nityc-d-robo/solenoid_driver/sd_hardware/sd_hardware.kicad_pcb

## KiCad design sd_hardware/sd_hardware.kicad_pcb (2026-10-19)

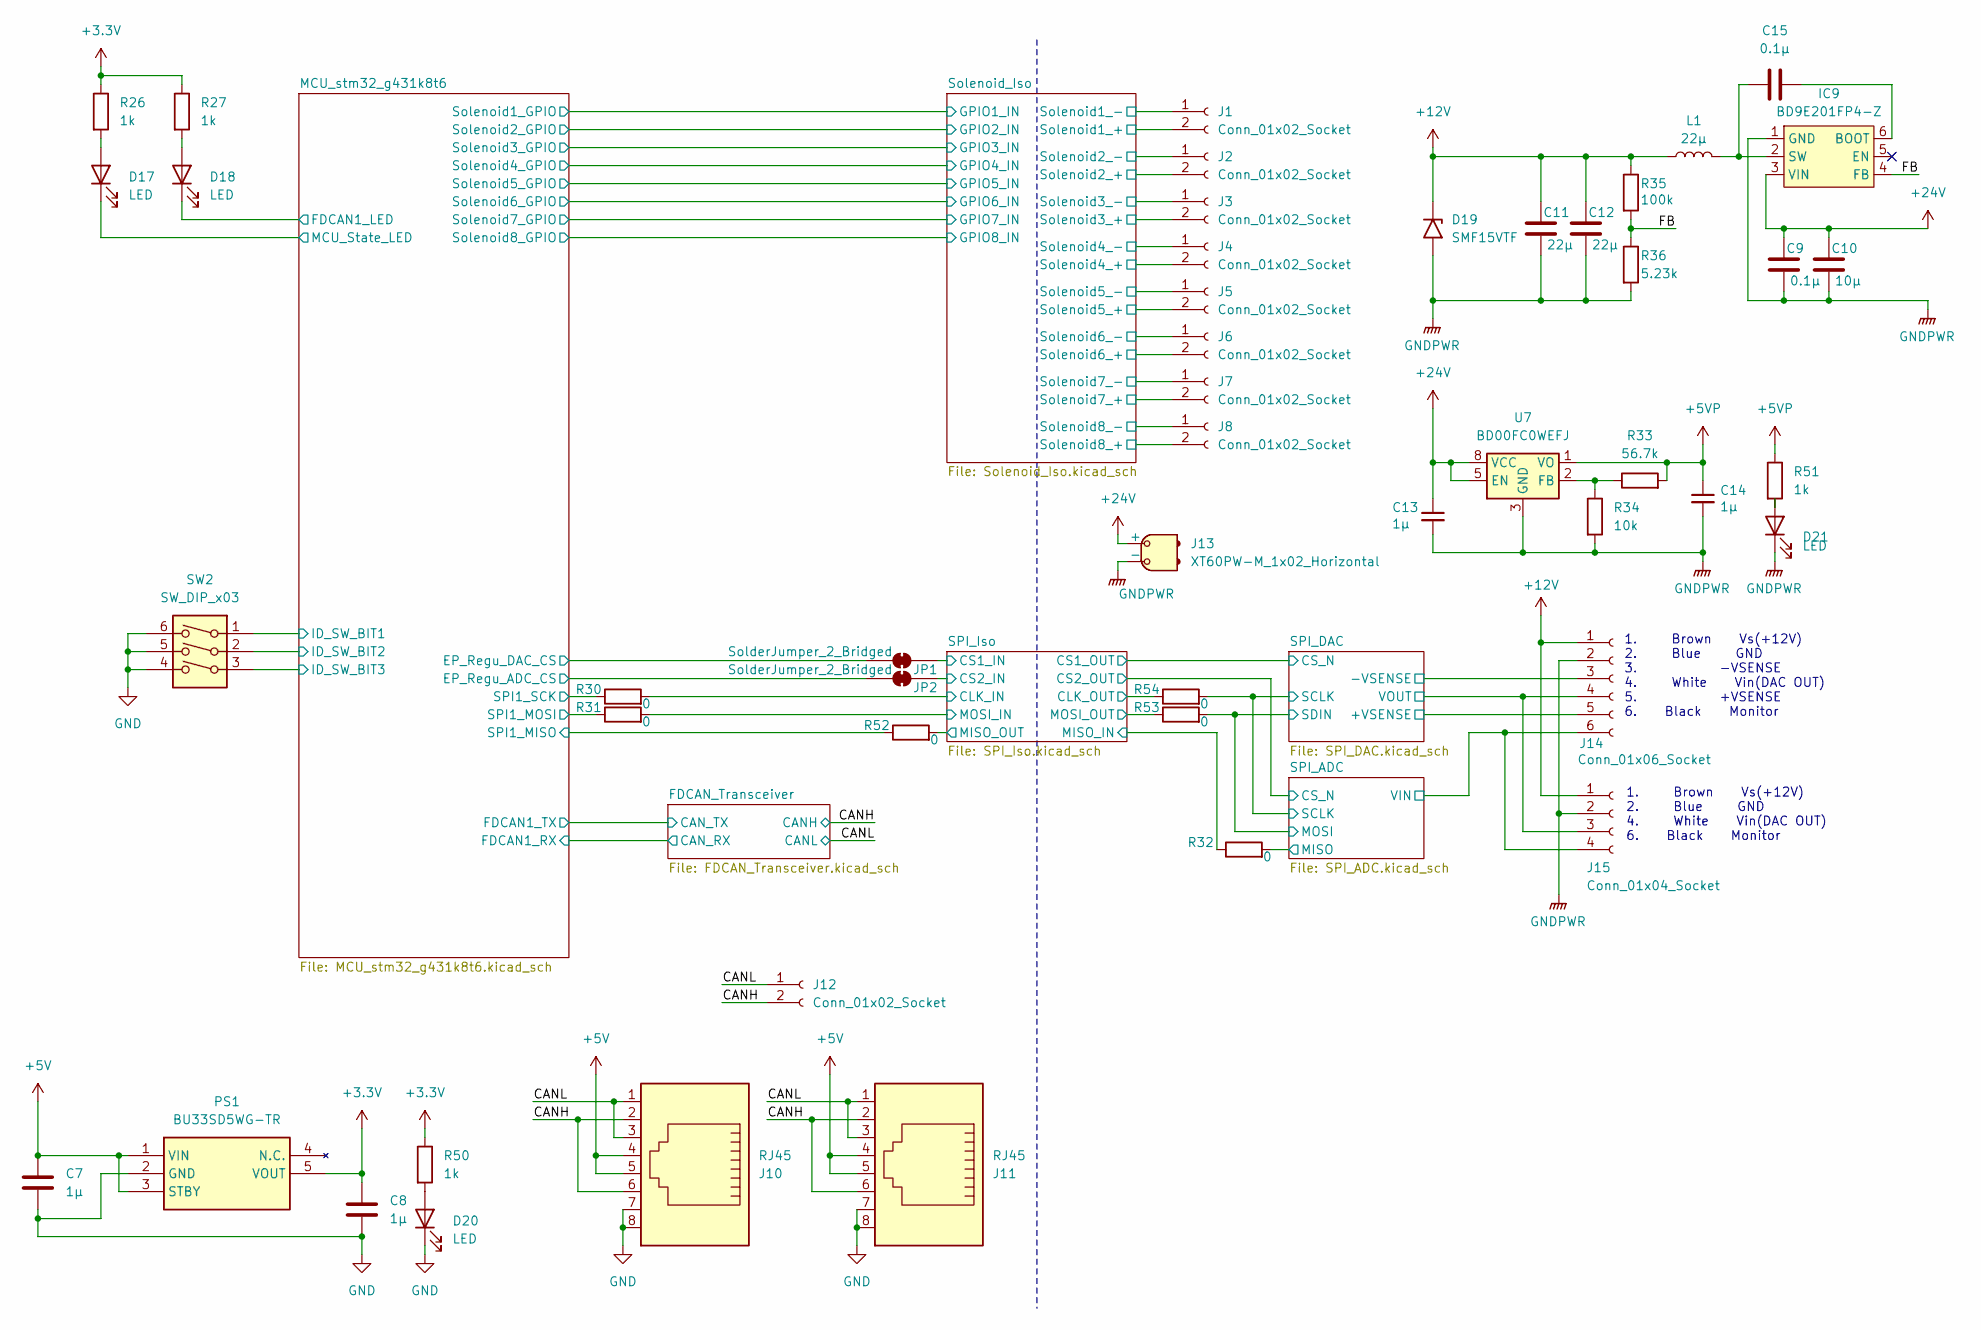
[picture p1: schematic sd_hardware.kicad_sch, Solenoid_Driver_3.1 - Yamana]

Parts:
C7, C8, C13, C14: 1μ; C_0603_1608Metric_Pad1.08x0.95mm_HandSolder
C9, C15: 0.1μ; C_0603_1608Metric_Pad1.08x0.95mm_HandSolder
C10: 10μ; C_0603_1608Metric_Pad1.08x0.95mm_HandSolder
C11, C12: 22μ; C_1210_3225Metric_Pad1.33x2.70mm_HandSolder
D17, D18, D20, D21: LED; LED_0603_1608Metric_Pad1.05x0.95mm_HandSolder
D19: SMF15VTF; D_SOD-123F
IC9: BD9E201FP4-Z; TSOT-23-6
J1, J2, J3, J4, J5, J6, J7, J8, J12: Conn_01x02_Socket; JST_XH_B2B-XH-A_1x02_P2.50mm_Vertical
J10, J11: RJ45; RJ45_Amphenol_54602-x08_Horizontal
J13: XT60PW-M_1x02_Horizontal; AMASS_XT60PW-M_1x02_P7.20mm_Horizontal
J14: Conn_01x06_Socket; JST_XH_B6B-XH-A_1x06_P2.50mm_Vertical
J15: Conn_01x04_Socket; JST_XH_B4B-XH-A_1x04_P2.50mm_Vertical
JP1, JP2: SolderJumper_2_Bridged; SolderJumper-2_P1.3mm_Bridged2Bar_RoundedPad1.0x1.5mm
L1: 22μ; RP1315BNP-220M
PS1: BU33SD5WG-TR; SOT95P280X125-5N; Mouser Part Number 755-BU33SD5WG-TR
R26, R27, R50, R51: 1k; R_0603_1608Metric_Pad0.98x0.95mm_HandSolder
R30, R31, R32, R52, R53, R54: 0; R_0603_1608Metric_Pad0.98x0.95mm_HandSolder
R33: 56.7k; R_0603_1608Metric_Pad0.98x0.95mm_HandSolder
R34: 10k; R_0603_1608Metric_Pad0.98x0.95mm_HandSolder
R35: 100k; R_0603_1608Metric_Pad0.98x0.95mm_HandSolder
R36: 5.23k; R_0603_1608Metric_Pad0.98x0.95mm_HandSolder
SW2: SW_DIP_x03; DS04-254-2-03BK-SMT
U7: BD00FC0WEFJ; HTSOP-8-1EP_3.9x4.9mm_P1.27mm_EP2.4x3.2mm

Connections:
+3.3V: C8.1, PS1.5 (VOUT), R26.1, R27.1, R50.1; also elsewhere on the board
+5V: C7.1, J10.4, J10.5, J11.4, J11.5, PS1.1 (VIN), PS1.3 (STBY); also elsewhere on the board
+5VP: C14.1, R33.2, R51.1, U7.1 (VO); also elsewhere on the board
+12V: C11.1, C12.1, D19.1 (A1), J1.2, J2.2, J3.2, J4.2, J5.2, J6.2, J7.2, J8.2, J14.1, J15.1, L1.1, R35.1; also elsewhere on the board
+24V: C9.1, C10.1, C13.1, IC9.3 (VIN), J13.2 (+), U7.5 (EN), U7.8 (VCC)
/CANH: J10.2, J10.6, J11.2, J11.6, J12.2; also elsewhere on the board
/CANL: J10.1, J10.3, J11.1, J11.3, J12.1; also elsewhere on the board
/FB: IC9.4 (FB), R35.2, R36.1
/MCU_stm32_g431k8t6/EP_Regu_ADC_CS: JP2.1 (A); also elsewhere on the board
/MCU_stm32_g431k8t6/EP_Regu_DAC_CS: JP1.1 (A); also elsewhere on the board
/MCU_stm32_g431k8t6/FDCAN1_LED: D18.1 (K); also elsewhere on the board
/MCU_stm32_g431k8t6/ID_SW_BIT1: SW2.1; also elsewhere on the board
/MCU_stm32_g431k8t6/ID_SW_BIT2: SW2.2; also elsewhere on the board
/MCU_stm32_g431k8t6/ID_SW_BIT3: SW2.3; also elsewhere on the board
/MCU_stm32_g431k8t6/MCU_State_LED: D17.1 (K); also elsewhere on the board
/MCU_stm32_g431k8t6/SPI1_MISO: R52.1; also elsewhere on the board
/MCU_stm32_g431k8t6/SPI1_MOSI: R31.1; also elsewhere on the board
/MCU_stm32_g431k8t6/SPI1_SCK: R30.1; also elsewhere on the board
/SPI_ADC/MISO: R32.2; also elsewhere on the board
/SPI_ADC/MOSI: R53.2; also elsewhere on the board
/SPI_ADC/SCLK: R54.2; also elsewhere on the board
/SPI_ADC/VIN: J14.6, J15.4; also elsewhere on the board
/SPI_DAC/+VSENSE: J14.5; also elsewhere on the board
/SPI_DAC/-VSENSE: J14.3; also elsewhere on the board
/SPI_DAC/VOUT: J14.4, J15.3; also elsewhere on the board
/SPI_Iso/CLK_IN: R30.2; also elsewhere on the board
/SPI_Iso/CLK_OUT: R54.1; also elsewhere on the board
/SPI_Iso/CS1_IN: JP1.2 (B); also elsewhere on the board
/SPI_Iso/CS2_IN: JP2.2 (B); also elsewhere on the board
/SPI_Iso/MISO_IN: R32.1; also elsewhere on the board
/SPI_Iso/MISO_OUT: R52.2; also elsewhere on the board
/SPI_Iso/MOSI_IN: R31.2; also elsewhere on the board
/SPI_Iso/MOSI_OUT: R53.1; also elsewhere on the board
/Solenoid_Iso/PhotoRelay1_Drain: J1.1; also elsewhere on the board
/Solenoid_Iso/PhotoRelay2_Drain: J2.1; also elsewhere on the board
/Solenoid_Iso/PhotoRelay3_Drain: J3.1; also elsewhere on the board
/Solenoid_Iso/PhotoRelay4_Drain: J4.1; also elsewhere on the board
/Solenoid_Iso/PhotoRelay5_Drain: J5.1; also elsewhere on the board
/Solenoid_Iso/PhotoRelay6_Drain: J6.1; also elsewhere on the board
/Solenoid_Iso/PhotoRelay7_Drain: J7.1; also elsewhere on the board
/Solenoid_Iso/PhotoRelay8_Drain: J8.1; also elsewhere on the board
GND: C7.2, C8.2, D20.1 (K), J10.7, J10.8, J11.7, J11.8, PS1.2 (GND), SW2.4, SW2.5, SW2.6; also elsewhere on the board
GNDPWR: C9.2, C10.2, C11.2, C12.2, C13.2, C14.2, D19.2 (A2), D21.1 (K), IC9.1 (GND), J13.1 (-), J14.2, J15.2, R34.2, R36.2, U7.3 (GND), U7.9 (GND); also elsewhere on the board
unnamed: D17.2 (A), R26.2
unnamed: D18.2 (A), R27.2
unnamed: D20.2 (A), R50.2
unnamed: D21.2 (A), R51.2
unnamed: C15.2, IC9.6 (BOOT)
unnamed: C15.1, IC9.2 (SW), L1.2
unnamed: R33.1, R34.1, U7.2 (FB)

Notes on the sheet:
1. Brown Vs(+12V) 2. Blue GND 3. -VSENSE 4. White Vin(DAC OUT) 5. +VSENSE 6. Black Monitor
1. Brown Vs(+12V) 2. Blue GND 4. White Vin(DAC OUT) 6. Black Monitor

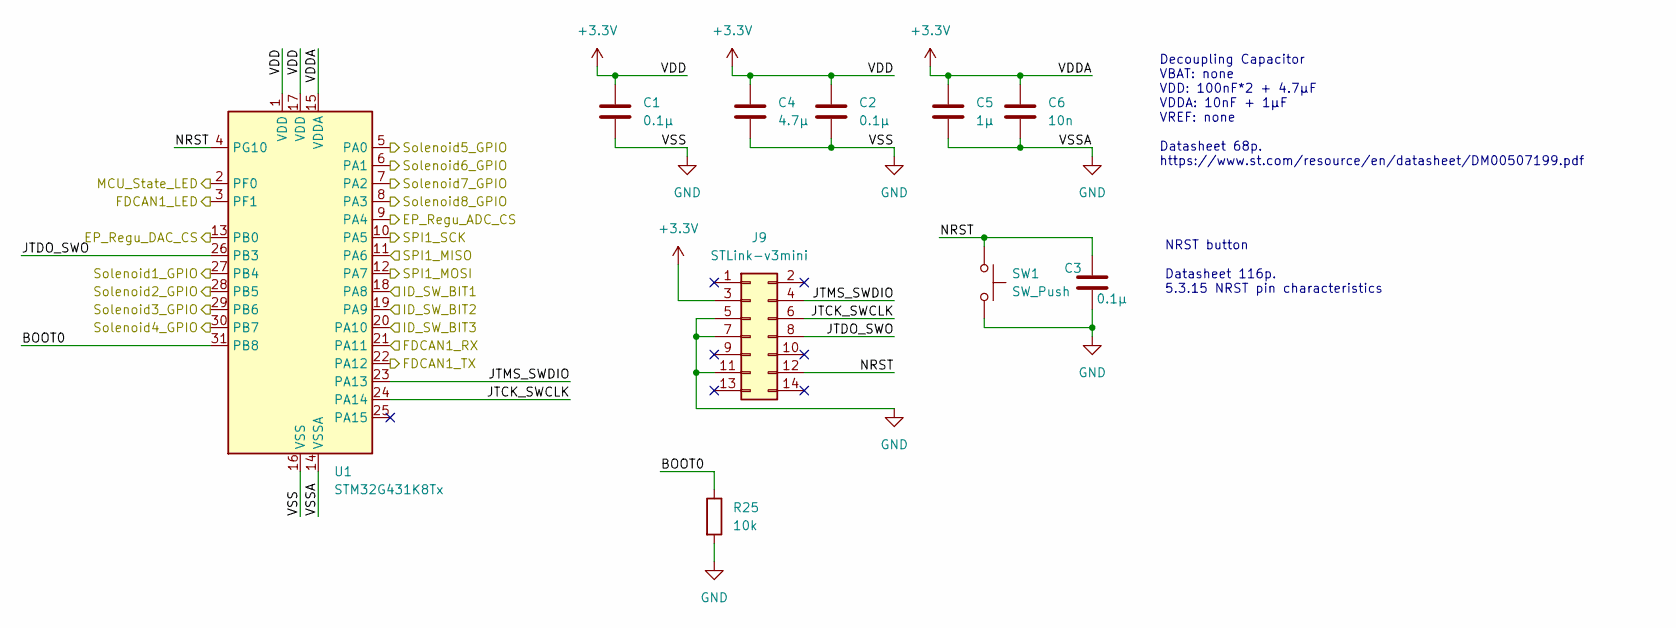
[picture p2: schematic MCU_stm32_g431k8t6.kicad_sch, Solenoid_Driver_3.1 - Yamana]

Parts:
C1, C2, C3: 0.1μ; C_0603_1608Metric_Pad1.08x0.95mm_HandSolder
C4: 4.7μ; C_0603_1608Metric_Pad1.08x0.95mm_HandSolder
C5: 1μ; C_0603_1608Metric_Pad1.08x0.95mm_HandSolder
C6: 10n; C_0603_1608Metric_Pad1.08x0.95mm_HandSolder
J9: STLink-v3mini; CONN14_3220-14_CNC
R25: 10k; R_0603_1608Metric_Pad0.98x0.95mm_HandSolder
SW1: SW_Push; TVAF06-A020B-R
U1: STM32G431K8Tx; LQFP-32_7x7mm_P0.8mm

Connections:
+3.3V: C1.1, C2.1, C4.1, C5.1, C6.1, J9.3, U1.1 (VDD), U1.15 (VDDA), U1.17 (VDD); also elsewhere on the board
/FDCAN_Transceiver/CAN_RX: U1.21 (PA11); also elsewhere on the board
/FDCAN_Transceiver/CAN_TX: U1.22 (PA12); also elsewhere on the board
/MCU_stm32_g431k8t6/BOOT0: R25.1, U1.31 (PB8)
/MCU_stm32_g431k8t6/EP_Regu_ADC_CS: U1.9 (PA4); also elsewhere on the board
/MCU_stm32_g431k8t6/EP_Regu_DAC_CS: U1.13 (PB0); also elsewhere on the board
/MCU_stm32_g431k8t6/FDCAN1_LED: U1.3 (PF1); also elsewhere on the board
/MCU_stm32_g431k8t6/ID_SW_BIT1: U1.18 (PA8); also elsewhere on the board
/MCU_stm32_g431k8t6/ID_SW_BIT2: U1.19 (PA9); also elsewhere on the board
/MCU_stm32_g431k8t6/ID_SW_BIT3: U1.20 (PA10); also elsewhere on the board
/MCU_stm32_g431k8t6/JTCK_SWCLK: J9.6, U1.24 (PA14)
/MCU_stm32_g431k8t6/JTDO_SWO: J9.8, U1.26 (PB3)
/MCU_stm32_g431k8t6/JTMS_SWDIO: J9.4, U1.23 (PA13)
/MCU_stm32_g431k8t6/MCU_State_LED: U1.2 (PF0); also elsewhere on the board
/MCU_stm32_g431k8t6/NRST: C3.1, J9.12, SW1.1, U1.4 (PG10)
/MCU_stm32_g431k8t6/SPI1_MISO: U1.11 (PA6); also elsewhere on the board
/MCU_stm32_g431k8t6/SPI1_MOSI: U1.12 (PA7); also elsewhere on the board
/MCU_stm32_g431k8t6/SPI1_SCK: U1.10 (PA5); also elsewhere on the board
/MCU_stm32_g431k8t6/Solenoid1_GPIO: U1.27 (PB4); also elsewhere on the board
/MCU_stm32_g431k8t6/Solenoid2_GPIO: U1.28 (PB5); also elsewhere on the board
/MCU_stm32_g431k8t6/Solenoid3_GPIO: U1.29 (PB6); also elsewhere on the board
/MCU_stm32_g431k8t6/Solenoid4_GPIO: U1.30 (PB7); also elsewhere on the board
/MCU_stm32_g431k8t6/Solenoid5_GPIO: U1.5 (PA0); also elsewhere on the board
/MCU_stm32_g431k8t6/Solenoid6_GPIO: U1.6 (PA1); also elsewhere on the board
/MCU_stm32_g431k8t6/Solenoid7_GPIO: U1.7 (PA2); also elsewhere on the board
/MCU_stm32_g431k8t6/Solenoid8_GPIO: U1.8 (PA3); also elsewhere on the board
GND: C1.2, C2.2, C3.2, C4.2, C5.2, C6.2, J9.5, J9.7, J9.11, R25.2, SW1.2, U1.14 (VSSA), U1.16 (VSS), U1.32 (VSS); also elsewhere on the board

Notes on the sheet:
Decoupling Capacitor VBAT: none VDD: 100nF*2 + 4.7μF VDDA: 10nF + 1μF VREF: none Datasheet 68p. https://www.st.com/resource/en/datasheet/DM00507199.pdf
NRST button Datasheet 116p. 5.3.15 NRST pin characteristics

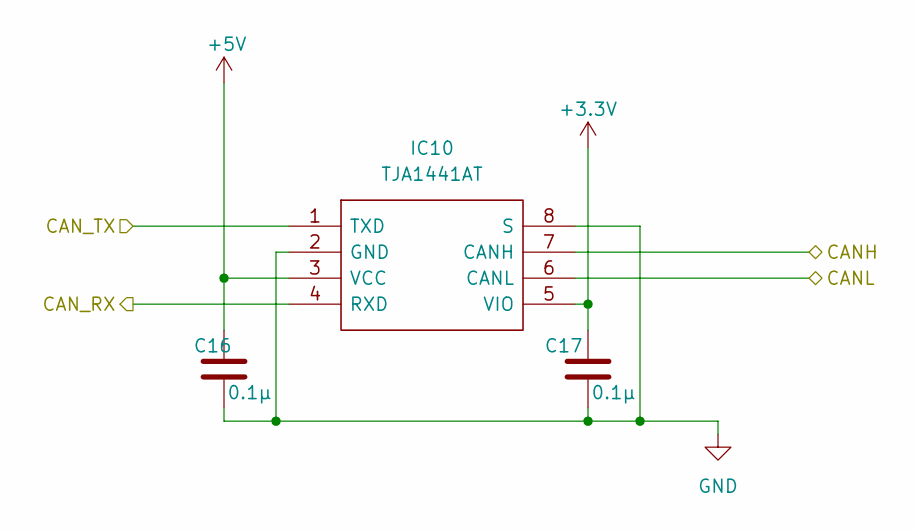
[picture p3: schematic FDCAN_Transceiver.kicad_sch, Solenoid_Driver_3.1 - Yamana]

Parts:
C16, C17: 0.1μ; C_0603_1608Metric_Pad1.08x0.95mm_HandSolder
IC10: TJA1441AT; SOIC127P600X175-8N; Manufacturer_Part_Number TJA1441AT

Connections:
+3.3V: C17.1, IC10.5 (VIO); also elsewhere on the board
+5V: C16.1, IC10.3 (VCC); also elsewhere on the board
/CANH: IC10.7 (CANH); also elsewhere on the board
/CANL: IC10.6 (CANL); also elsewhere on the board
/FDCAN_Transceiver/CAN_RX: IC10.4 (RXD); also elsewhere on the board
/FDCAN_Transceiver/CAN_TX: IC10.1 (TXD); also elsewhere on the board
GND: C16.2, C17.2, IC10.2 (GND), IC10.8 (S); also elsewhere on the board

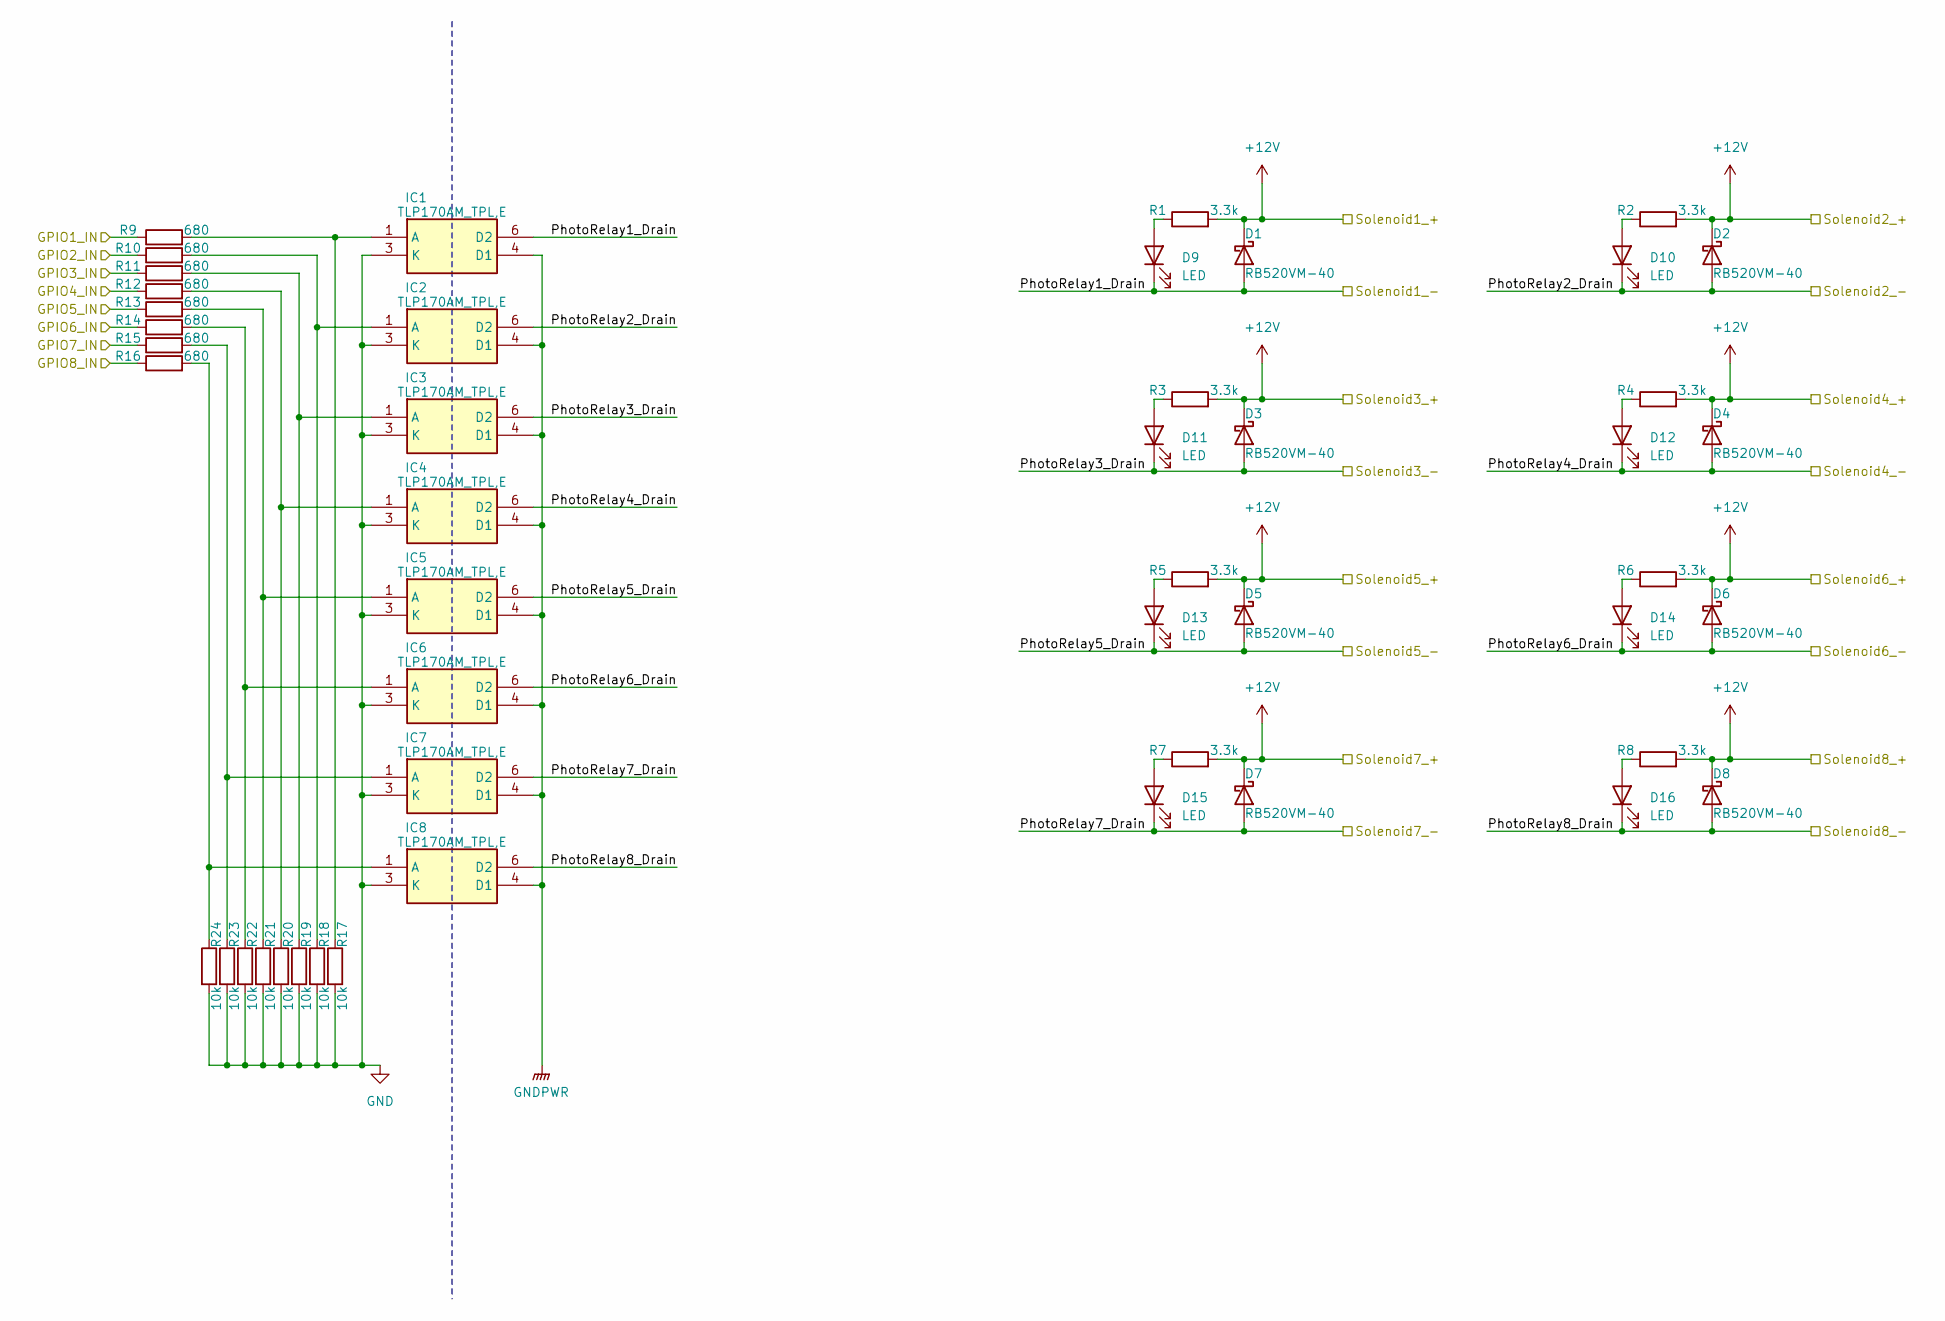
[picture p4: schematic Solenoid_Iso.kicad_sch, Solenoid_Driver_3.1 - Yamana]

Parts:
D1, D2, D3, D4, D5, D6, D7, D8: RB520VM-40; D_SOD-323_HandSoldering
D9, D10, D11, D12, D13, D14, D15, D16: LED; LED_0603_1608Metric_Pad1.05x0.95mm_HandSolder
IC1, IC2, IC3, IC4, IC5, IC6, IC7, IC8: TLP170AM_TPL,E; TLP170AMTPLE; Mouser Part Number 757-TLP170AM(TPL,E
R1, R2, R3, R4, R5, R6, R7, R8: 3.3k; R_0603_1608Metric_Pad0.98x0.95mm_HandSolder
R9, R10, R11, R12, R13, R14, R15, R16: 680; R_0603_1608Metric_Pad0.98x0.95mm_HandSolder
R17, R18, R19, R20, R21, R22, R23, R24: 10k; R_0603_1608Metric_Pad0.98x0.95mm_HandSolder

Connections:
+12V: D1.1 (K), D2.1 (K), D3.1 (K), D4.1 (K), D5.1 (K), D6.1 (K), D7.1 (K), D8.1 (K), R1.2, R2.2, R3.2, R4.2, R5.2, R6.2, R7.2, R8.2; also elsewhere on the board
/MCU_stm32_g431k8t6/Solenoid1_GPIO: R9.1; also elsewhere on the board
/MCU_stm32_g431k8t6/Solenoid2_GPIO: R10.1; also elsewhere on the board
/MCU_stm32_g431k8t6/Solenoid3_GPIO: R11.1; also elsewhere on the board
/MCU_stm32_g431k8t6/Solenoid4_GPIO: R12.1; also elsewhere on the board
/MCU_stm32_g431k8t6/Solenoid5_GPIO: R13.1; also elsewhere on the board
/MCU_stm32_g431k8t6/Solenoid6_GPIO: R14.1; also elsewhere on the board
/MCU_stm32_g431k8t6/Solenoid7_GPIO: R15.1; also elsewhere on the board
/MCU_stm32_g431k8t6/Solenoid8_GPIO: R16.1; also elsewhere on the board
/Solenoid_Iso/PhotoRelay1_Drain: D1.2 (A), D9.1 (K), IC1.6 (D2); also elsewhere on the board
/Solenoid_Iso/PhotoRelay2_Drain: D2.2 (A), D10.1 (K), IC2.6 (D2); also elsewhere on the board
/Solenoid_Iso/PhotoRelay3_Drain: D3.2 (A), D11.1 (K), IC3.6 (D2); also elsewhere on the board
/Solenoid_Iso/PhotoRelay4_Drain: D4.2 (A), D12.1 (K), IC4.6 (D2); also elsewhere on the board
/Solenoid_Iso/PhotoRelay5_Drain: D5.2 (A), D13.1 (K), IC5.6 (D2); also elsewhere on the board
/Solenoid_Iso/PhotoRelay6_Drain: D6.2 (A), D14.1 (K), IC6.6 (D2); also elsewhere on the board
/Solenoid_Iso/PhotoRelay7_Drain: D7.2 (A), D15.1 (K), IC7.6 (D2); also elsewhere on the board
/Solenoid_Iso/PhotoRelay8_Drain: D8.2 (A), D16.1 (K), IC8.6 (D2); also elsewhere on the board
GND: IC1.3 (K), IC2.3 (K), IC3.3 (K), IC4.3 (K), IC5.3 (K), IC6.3 (K), IC7.3 (K), IC8.3 (K), R17.2, R18.2, R19.2, R20.2, R21.2, R22.2, R23.2, R24.2; also elsewhere on the board
GNDPWR: IC1.4 (D1), IC2.4 (D1), IC3.4 (D1), IC4.4 (D1), IC5.4 (D1), IC6.4 (D1), IC7.4 (D1), IC8.4 (D1); also elsewhere on the board
unnamed: D9.2 (A), R1.1
unnamed: D10.2 (A), R2.1
unnamed: D11.2 (A), R3.1
unnamed: D12.2 (A), R4.1
unnamed: D13.2 (A), R5.1
unnamed: D14.2 (A), R6.1
unnamed: D15.2 (A), R7.1
unnamed: D16.2 (A), R8.1
unnamed: IC1.1 (A), R9.2, R17.1
unnamed: IC2.1 (A), R10.2, R18.1
unnamed: IC3.1 (A), R11.2, R19.1
unnamed: IC4.1 (A), R12.2, R20.1
unnamed: IC5.1 (A), R13.2, R21.1
unnamed: IC6.1 (A), R14.2, R22.1
unnamed: IC7.1 (A), R15.2, R23.1
unnamed: IC8.1 (A), R16.2, R24.1

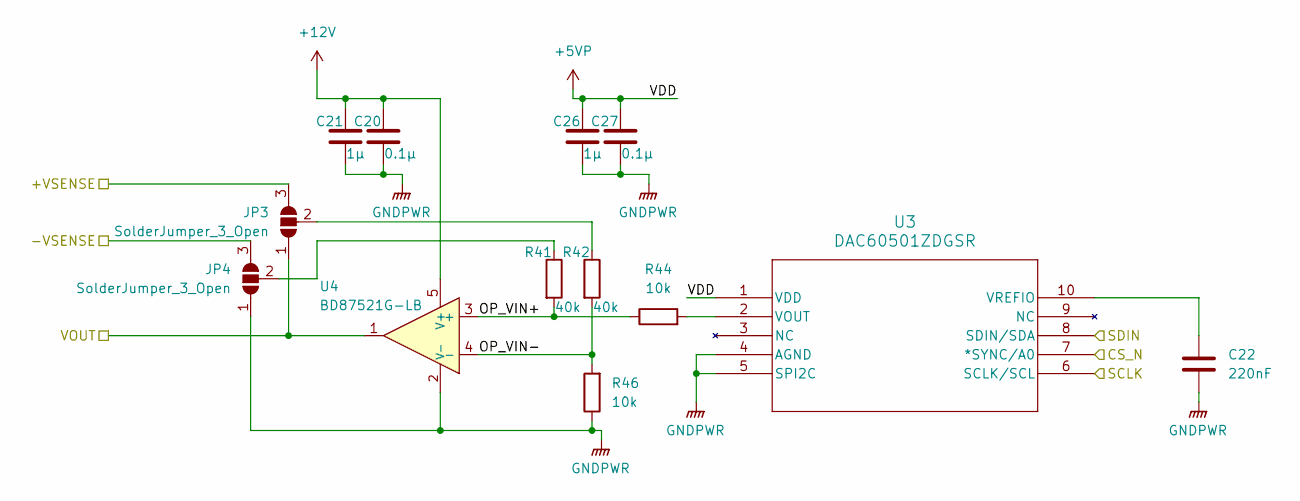
[picture p5: schematic SPI_DAC.kicad_sch, Solenoid_Driver_3.1 - Yamana]

Parts:
C20, C27: 0.1μ; C_0603_1608Metric_Pad1.08x0.95mm_HandSolder
C21, C26: 1μ; C_0603_1608Metric_Pad1.08x0.95mm_HandSolder
C22: 220nF; C_0603_1608Metric_Pad1.08x0.95mm_HandSolder
JP3, JP4: SolderJumper_3_Open; SolderJumper-3_P1.3mm_Open_RoundedPad1.0x1.5mm_NumberLabels
R41, R42: 40k; R_0603_1608Metric_Pad0.98x0.95mm_HandSolder
R44, R46: 10k; R_0603_1608Metric_Pad0.98x0.95mm_HandSolder
U3: DAC60501ZDGSR; DGS10_TEX
U4: BD87521G-LB; SOT95P280X125-5N

Connections:
+5VP: C26.1, C27.1, U3.1 (VDD); also elsewhere on the board
+12V: C20.1, C21.1, U4.5 (V+); also elsewhere on the board
/SPI_ADC/MOSI: U3.8 (SDIN/SDA); also elsewhere on the board
/SPI_ADC/SCLK: U3.6 (SCLK/SCL); also elsewhere on the board
/SPI_DAC/+VSENSE: JP3.3 (B); also elsewhere on the board
/SPI_DAC/-VSENSE: JP4.3 (B); also elsewhere on the board
/SPI_DAC/CS_N: U3.7 (*SYNC/A0); also elsewhere on the board
/SPI_DAC/OP_VIN+: R41.2, R44.1, U4.3 (+)
/SPI_DAC/OP_VIN-: R42.2, R46.2, U4.4 (-)
/SPI_DAC/VOUT: JP3.1 (A), U4.1; also elsewhere on the board
GNDPWR: C20.2, C21.2, C22.2, C26.2, C27.2, JP4.1 (A), R46.1, U3.4 (AGND), U3.5 (SPI2C), U4.2 (V-); also elsewhere on the board
unnamed: JP3.2 (C), R42.1
unnamed: JP4.2 (C), R41.1
unnamed: R44.2, U3.2 (VOUT)
unnamed: C22.1, U3.10 (VREFIO)

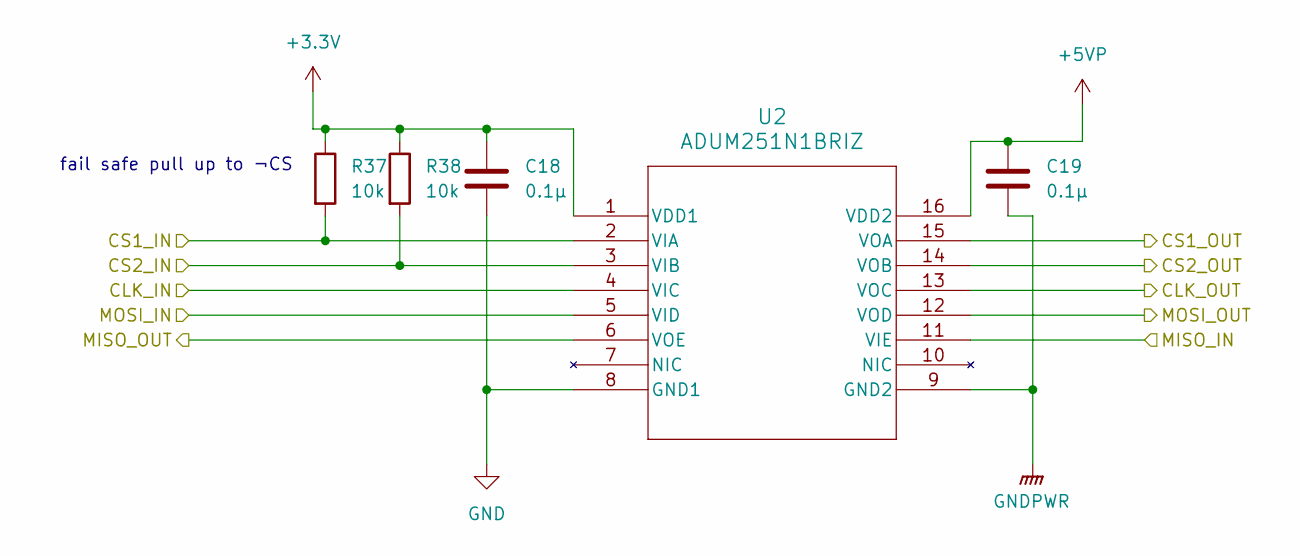
[picture p6: schematic SPI_Iso.kicad_sch, Solenoid_Driver_3.1 - Yamana]

Parts:
C18, C19: 0.1μ; C_0603_1608Metric_Pad1.08x0.95mm_HandSolder
R37, R38: 10k; R_0603_1608Metric_Pad0.98x0.95mm_HandSolder
U2: ADUM251N1BRIZ; ADUM251N1BRIZ_ADI

Connections:
+3.3V: C18.1, R37.1, R38.1, U2.1 (VDD1); also elsewhere on the board
+5VP: C19.1, U2.16 (VDD2); also elsewhere on the board
/SPI_ADC/CS_N: U2.14 (VOB); also elsewhere on the board
/SPI_DAC/CS_N: U2.15 (VOA); also elsewhere on the board
/SPI_Iso/CLK_IN: U2.4 (VIC); also elsewhere on the board
/SPI_Iso/CLK_OUT: U2.13 (VOC); also elsewhere on the board
/SPI_Iso/CS1_IN: R37.2, U2.2 (VIA); also elsewhere on the board
/SPI_Iso/CS2_IN: R38.2, U2.3 (VIB); also elsewhere on the board
/SPI_Iso/MISO_IN: U2.11 (VIE); also elsewhere on the board
/SPI_Iso/MISO_OUT: U2.6 (VOE); also elsewhere on the board
/SPI_Iso/MOSI_IN: U2.5 (VID); also elsewhere on the board
/SPI_Iso/MOSI_OUT: U2.12 (VOD); also elsewhere on the board
GND: C18.2, U2.8 (GND1); also elsewhere on the board
GNDPWR: C19.2, U2.9 (GND2); also elsewhere on the board

Notes on the sheet:
fail safe pull up to ¬CS

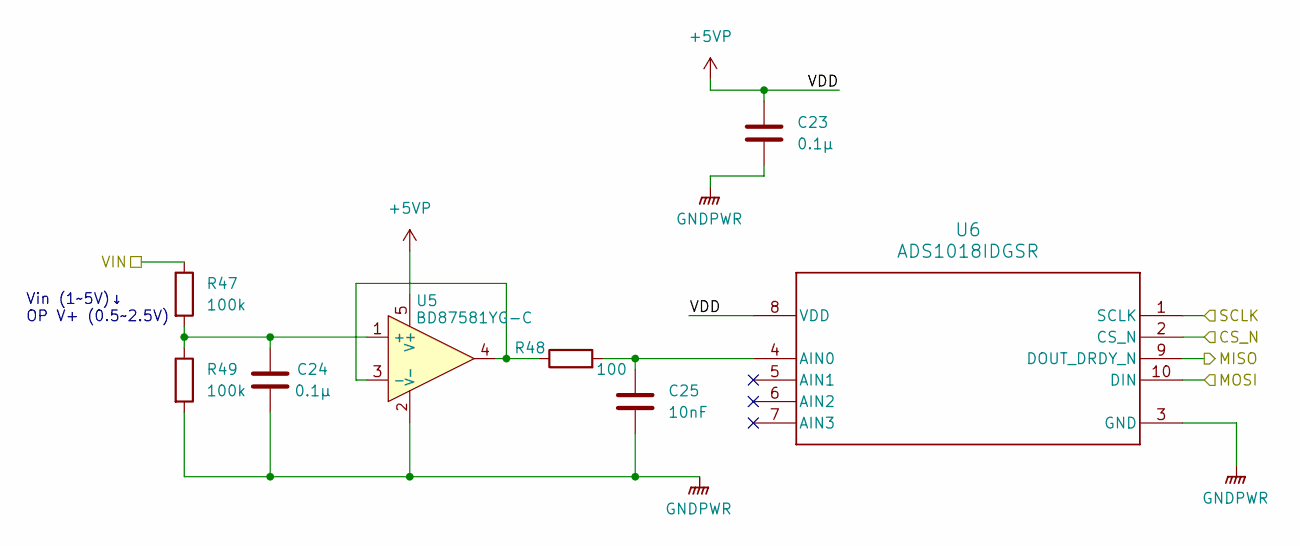
[picture p7: schematic SPI_ADC.kicad_sch, Solenoid_Driver_3.1 - Yamana]

Parts:
C23, C24: 0.1μ; C_0603_1608Metric_Pad1.08x0.95mm_HandSolder
C25: 10nF; C_0603_1608Metric_Pad1.08x0.95mm_HandSolder
R47, R49: 100k; R_0603_1608Metric_Pad0.98x0.95mm_HandSolder
R48: 100; R_0603_1608Metric_Pad0.98x0.95mm_HandSolder
U5: BD87581YG-C; SOT95P280X125-5N
U6: ADS1018IDGSR; DGS10_TEX

Connections:
+5VP: C23.1, U5.5 (V+), U6.8 (VDD); also elsewhere on the board
/SPI_ADC/CS_N: U6.2 (CS_N); also elsewhere on the board
/SPI_ADC/MISO: U6.9 (DOUT_DRDY_N); also elsewhere on the board
/SPI_ADC/MOSI: U6.10 (DIN); also elsewhere on the board
/SPI_ADC/SCLK: U6.1 (SCLK); also elsewhere on the board
/SPI_ADC/VIN: R47.1; also elsewhere on the board
GNDPWR: C23.2, C24.2, C25.2, R49.2, U5.2 (V-), U6.3 (GND); also elsewhere on the board
unnamed: C24.1, R47.2, R49.1, U5.1 (+)
unnamed: R48.1, U5.3 (-), U5.4
unnamed: C25.1, R48.2, U6.4 (AIN0)

Notes on the sheet:
Vin (1~5V)↓ OP V+ (0.5~2.5V)

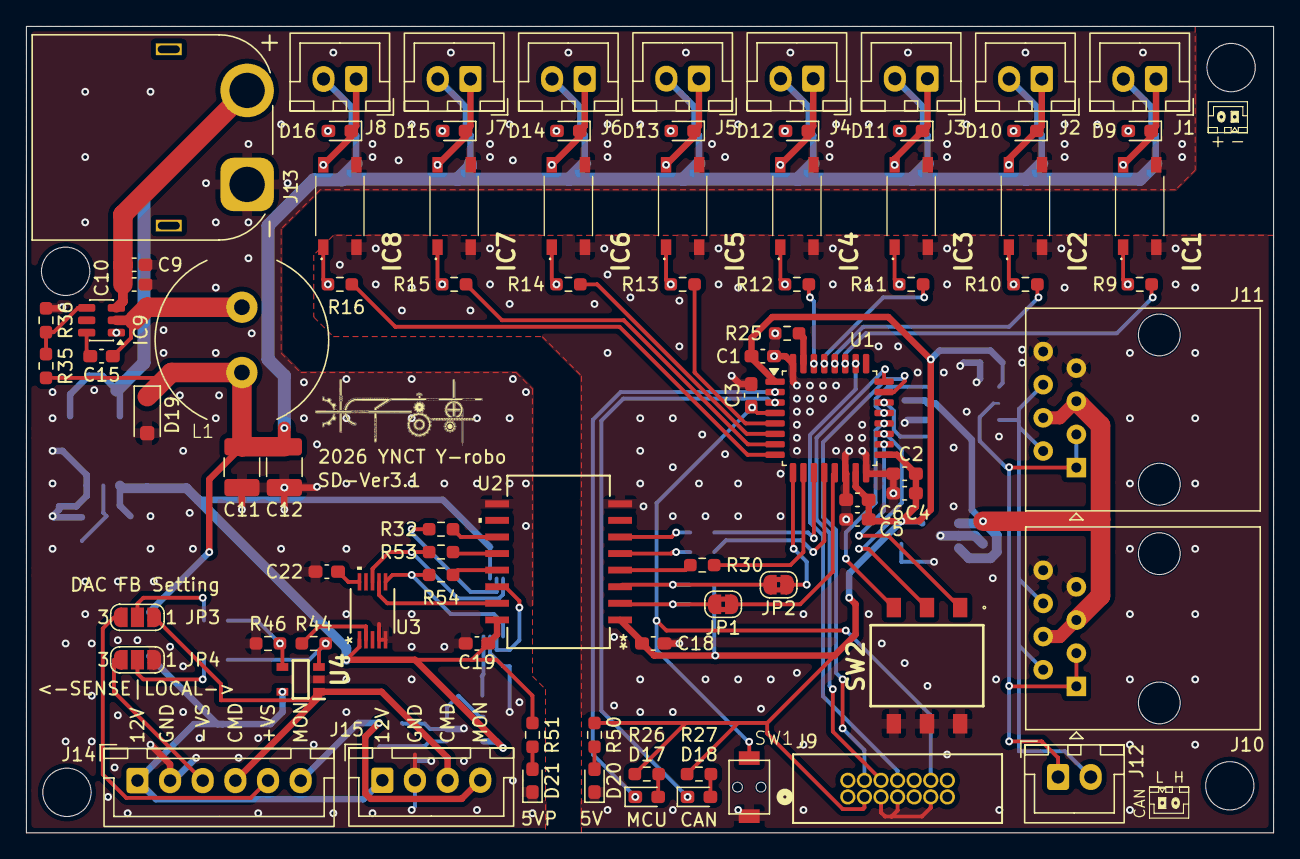
[picture p8: board sd_hardware.kicad_pcb from above]

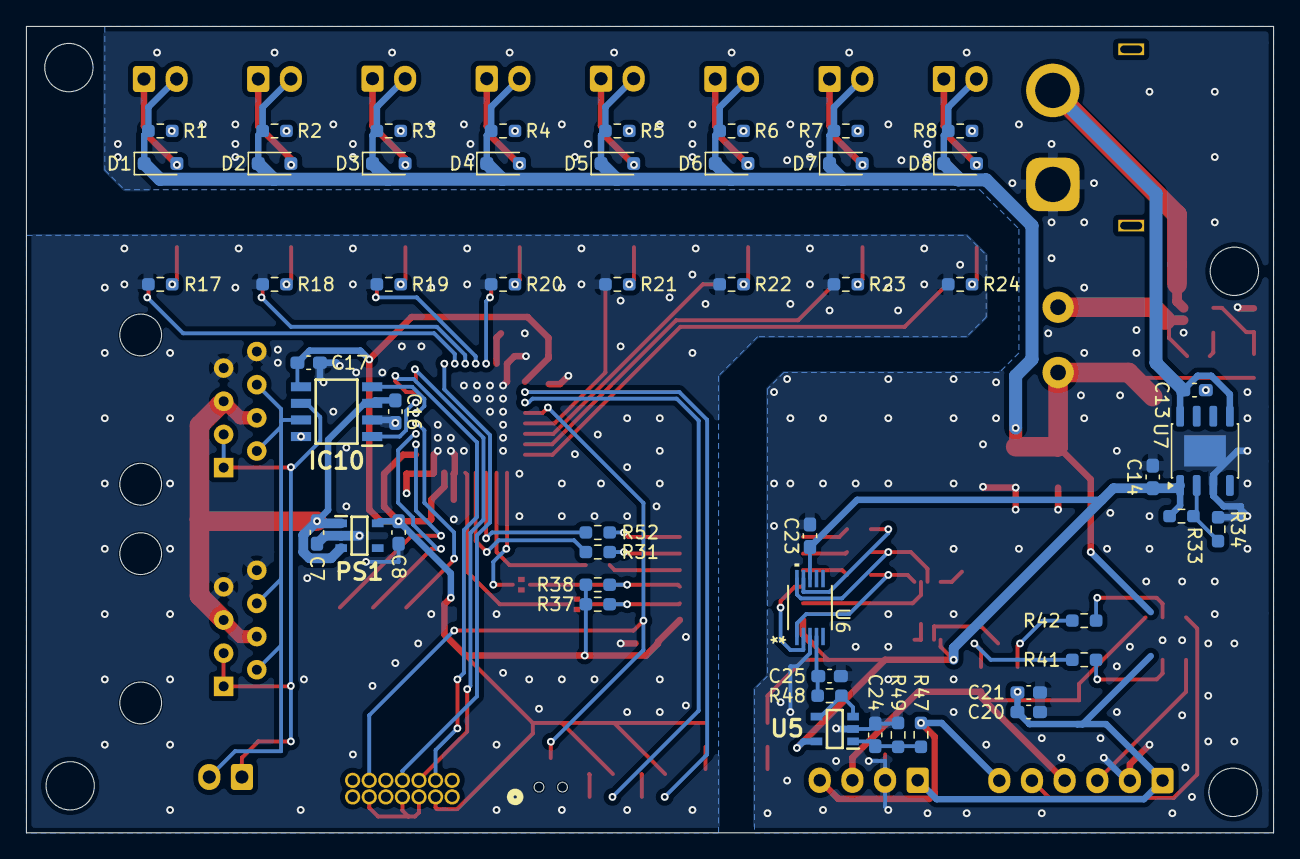
[picture p9: board sd_hardware.kicad_pcb from below]

Board: 2 copper layers, 95.5 x 61.8 mm, 134 parts (51 on the bottom side), 92 nets.
