nityc-d-robo/solenoid_driver/sd_firmware/Core/Src/main.c

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
/* Includes ------------------------------------------------------------------*/
#include "main.h"
#include "fdcan.h"
#include "spi.h"
#include "tim.h"
#include "gpio.h"

/* USER CODE BEGIN Includes */
float_mpa target_value;
/* USER CODE END Includes */


void SystemClock_Config(void);
/**
  * @brief  The application entry point.
  * @retval int
  */
int main(void)
{

  /* MCU Configuration--------------------------------------------------------*/

  /* Reset of all peripherals, Initializes the Flash interface and the Systick. */
  HAL_Init();

  /* Configure the system clock */
  SystemClock_Config();

  /* Initialize all configured peripherals */
  MX_GPIO_Init();
  MX_FDCAN1_Init();
  MX_TIM16_Init();
  MX_SPI1_Init();
  /* USER CODE BEGIN 2 */
  HAL_TIM_Base_Start_IT(&htim16); // タイマー割り込み開始

  dac_init(0);
  HAL_GPIO_WritePin(MCU_State_LED_GPIO_Port, MCU_State_LED_Pin, GPIO_PIN_RESET);
  HAL_GPIO_WritePin(FDCAN1_LED_GPIO_Port, FDCAN1_LED_Pin, GPIO_PIN_RESET);
  /* USER CODE END 2 */

  /* Infinite loop */
  /* USER CODE BEGIN WHILE */
  while (1)
  {
    // dac_init(target_value.value);
    dac_set_MPa(target_value.value);
    HAL_Delay(100);
    /* USER CODE END WHILE */

    /* USER CODE BEGIN 3 */
  }
  /* USER CODE END 3 */
}

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
/* USER CODE BEGIN 4 */
//タイマーの周期ごとに自動で呼ばれる割り込み関数
void HAL_TIM_PeriodElapsedCallback(TIM_HandleTypeDef *htim){
  if (htim->Instance == TIM16){
  //最新のバッファ状態をGPIOへ一括反映
    updateSolenoidOutputs();
  }
}

/* USER CODE END 4 */
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
