nityc-d-robo/solenoid_driver/sd_firmware/sd_firmware.ioc

Mcu.UserName=STM32G431K8Tx
PA0.GPIO_Label=Solenoid5_GPIO
PA0.Signal=GPIO_Output
PA1.GPIO_Label=Solenoid6_GPIO
PA1.Signal=GPIO_Output
PA10.GPIO_Label=ID_SW_BIT3
PA10.Signal=GPIO_Input
PA11.Signal=FDCAN1_RX
PA12.Signal=FDCAN1_TX
PA13.Signal=SYS_JTMS-SWDIO
PA14.Signal=SYS_JTCK-SWCLK
PA2.GPIO_Label=Solenoid7_GPIO
PA2.Signal=GPIO_Output
PA3.GPIO_Label=Solenoid8_GPIO
PA3.Signal=GPIO_Output
PA4.GPIO_Label=ADC_CS
PA4.Signal=GPIO_Output
PA5.Signal=SPI1_SCK
PA6.Signal=SPI1_MISO
PA7.Signal=SPI1_MOSI
PA8.GPIO_Label=ID_SW_BIT1
PA8.Signal=GPIO_Input
PA9.GPIO_Label=ID_SW_BIT2
PA9.Signal=GPIO_Input
PB0.GPIO_Label=DAC_CS
PB0.Signal=GPIO_Output
PB3.Signal=SYS_JTDO-SWO
PB4.GPIO_Label=Solenoid1_GPIO
PB4.Signal=GPIO_Output
PB5.GPIO_Label=Solenoid2_GPIO
PB5.Signal=GPIO_Output
PB6.GPIO_Label=Solenoid3_GPIO
PB6.Signal=GPIO_Output
PB7.GPIO_Label=Solenoid4_GPIO
PB7.Signal=GPIO_Output
PF0-OSC_IN.GPIO_Label=MCU_State_LED
PF0-OSC_IN.Signal=GPIO_Output
PF1-OSC_OUT.GPIO_Label=FDCAN1_LED
PF1-OSC_OUT.Signal=GPIO_Output
