nityc-d-robo/solenoid_driver/sd_firmware/Core/Src/fdcan.c

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
/* Includes ------------------------------------------------------------------*/
#include "fdcan.h"

/* USER CODE BEGIN 0 */
#include "gpio.h"
#include "spi.h"

#define CAN_ID_ESTOP    0x000
#define CAN_ID_CMD_BASE 0x1A0
#define ID_OWN          0x3

static uint8_t myNodeID = 0;
/* USER CODE END 0 */

FDCAN_HandleTypeDef hfdcan1;

/* FDCAN1 init function */
void MX_FDCAN1_Init(void)
{

  hfdcan1.Instance = FDCAN1;
  hfdcan1.Init.ClockDivider = FDCAN_CLOCK_DIV1;
  hfdcan1.Init.FrameFormat = FDCAN_FRAME_CLASSIC;
  hfdcan1.Init.Mode = FDCAN_MODE_NORMAL;
  hfdcan1.Init.AutoRetransmission = DISABLE;
  hfdcan1.Init.TransmitPause = DISABLE;
  hfdcan1.Init.ProtocolException = DISABLE;
  hfdcan1.Init.NominalPrescaler = 3;
  hfdcan1.Init.NominalSyncJumpWidth = 1;
  hfdcan1.Init.NominalTimeSeg1 = 6;
  hfdcan1.Init.NominalTimeSeg2 = 1;
  hfdcan1.Init.DataPrescaler = 1;
  hfdcan1.Init.DataSyncJumpWidth = 1;
  hfdcan1.Init.DataTimeSeg1 = 1;
  hfdcan1.Init.DataTimeSeg2 = 1;
  hfdcan1.Init.StdFiltersNbr = 3;
  hfdcan1.Init.ExtFiltersNbr = 0;
  hfdcan1.Init.TxFifoQueueMode = FDCAN_TX_FIFO_OPERATION;
  if (HAL_FDCAN_Init(&hfdcan1) != HAL_OK)
  {
    Error_Handler();
  }
  /* USER CODE BEGIN FDCAN1_Init 2 */

  FDCAN_FilterTypeDef sFilterConfig;
  sFilterConfig.IdType = FDCAN_STANDARD_ID;
  sFilterConfig.FilterIndex = 0;
  sFilterConfig.FilterType = FDCAN_FILTER_MASK;
  sFilterConfig.FilterConfig = FDCAN_FILTER_TO_RXFIFO0;
  sFilterConfig.FilterID1 = FDCAN_FUNC_WRITE | ID_OWN;
  sFilterConfig.FilterID2 = FDCAN_MASK_FUNC | FDCAN_MASK_DEVICE;
  HAL_FDCAN_ConfigFilter(&hfdcan1, &sFilterConfig);

  sFilterConfig.IdType = FDCAN_STANDARD_ID;
  sFilterConfig.FilterIndex = 1;
  sFilterConfig.FilterType = FDCAN_FILTER_MASK;
  sFilterConfig.FilterConfig = FDCAN_FILTER_TO_RXFIFO0;
  sFilterConfig.FilterID1 = FDCAN_FUNC_READ | ID_OWN;
  sFilterConfig.FilterID2 = FDCAN_MASK_FUNC | FDCAN_MASK_DEVICE;
  HAL_FDCAN_ConfigFilter(&hfdcan1, &sFilterConfig);

  //旧CAN規格に対応  
  sFilterConfig.IdType = FDCAN_STANDARD_ID;
  sFilterConfig.FilterIndex = 2;
  sFilterConfig.FilterType = FDCAN_FILTER_MASK;
  sFilterConfig.FilterConfig = FDCAN_FILTER_TO_RXFIFO1;
  sFilterConfig.FilterID1 = (FDCAN_FUNC_TX << 8) | (FDCAN_BOARD_CLASS_8 << 5) | (BOARD_ID << 3);
  sFilterConfig.FilterID2 = FDCAN_MASK_FUNC_OLD | FDCAN_MASK_CLASS | FDCAN_MASK_BOARD_8;
  HAL_FDCAN_ConfigFilter(&hfdcan1, &sFilterConfig);

  HAL_FDCAN_ConfigGlobalFilter(&hfdcan1, FDCAN_REJECT, FDCAN_REJECT, FDCAN_FILTER_REMOTE, FDCAN_REJECT_REMOTE);
  HAL_FDCAN_ActivateNotification(&hfdcan1, FDCAN_IT_RX_FIFO0_NEW_MESSAGE, 0);
  HAL_FDCAN_ActivateNotification(&hfdcan1, FDCAN_IT_RX_FIFO1_NEW_MESSAGE, 0);
  HAL_FDCAN_Start(&hfdcan1);

  /* USER CODE END FDCAN1_Init 2 */

}

void HAL_FDCAN_MspInit(FDCAN_HandleTypeDef* fdcanHandle)
{

  GPIO_InitTypeDef GPIO_InitStruct = {0};
  RCC_PeriphCLKInitTypeDef PeriphClkInit = {0};
  if(fdcanHandle->Instance==FDCAN1)
  {
  /** Initializes the peripherals clocks
  */
    PeriphClkInit.PeriphClockSelection = RCC_PERIPHCLK_FDCAN;
    PeriphClkInit.FdcanClockSelection = RCC_FDCANCLKSOURCE_PCLK1;
    if (HAL_RCCEx_PeriphCLKConfig(&PeriphClkInit) != HAL_OK)
    {
      Error_Handler();
    }

    /* FDCAN1 clock enable */
    __HAL_RCC_FDCAN_CLK_ENABLE();

    __HAL_RCC_GPIOA_CLK_ENABLE();
    /**FDCAN1 GPIO Configuration
    PA11     ------> FDCAN1_RX
    PA12     ------> FDCAN1_TX
    */
    GPIO_InitStruct.Pin = GPIO_PIN_11|GPIO_PIN_12;
    GPIO_InitStruct.Mode = GPIO_MODE_AF_PP;
    GPIO_InitStruct.Pull = GPIO_NOPULL;
    GPIO_InitStruct.Speed = GPIO_SPEED_FREQ_LOW;
    GPIO_InitStruct.Alternate = GPIO_AF9_FDCAN1;
    HAL_GPIO_Init(GPIOA, &GPIO_InitStruct);

    /* FDCAN1 interrupt Init */
    HAL_NVIC_SetPriority(FDCAN1_IT0_IRQn, 0, 0);
    HAL_NVIC_EnableIRQ(FDCAN1_IT0_IRQn);
    HAL_NVIC_SetPriority(FDCAN1_IT1_IRQn, 0, 0);
    HAL_NVIC_EnableIRQ(FDCAN1_IT1_IRQn);
  }
}

void HAL_FDCAN_MspDeInit(FDCAN_HandleTypeDef* fdcanHandle)
{

  if(fdcanHandle->Instance==FDCAN1)
  {
    /* Peripheral clock disable */
    __HAL_RCC_FDCAN_CLK_DISABLE();

    /**FDCAN1 GPIO Configuration
    PA11     ------> FDCAN1_RX
    PA12     ------> FDCAN1_TX
    */
    HAL_GPIO_DeInit(GPIOA, GPIO_PIN_11|GPIO_PIN_12);

    /* FDCAN1 interrupt Deinit */
    HAL_NVIC_DisableIRQ(FDCAN1_IT0_IRQn);
    HAL_NVIC_DisableIRQ(FDCAN1_IT1_IRQn);
  }
}

/* USER CODE BEGIN 1 */
void HAL_FDCAN_RxFifo0Callback(FDCAN_HandleTypeDef *hfdcan, uint32_t RxFifo0ITs){
  if ((RxFifo0ITs & FDCAN_IT_RX_FIFO0_NEW_MESSAGE) != 0){
    FDCAN_RxHeaderTypeDef RxHeader;
    uint8_t RxData[8];

    if (HAL_FDCAN_GetRxMessage(hfdcan, FDCAN_RX_FIFO0, &RxHeader, RxData) == HAL_OK){
      uint32_t rxId = RxHeader.Identifier;

      if ((rxId & FDCAN_MASK_FUNC) == FDCAN_FUNC_WRITE) {
        uint8_t addr = RxData[0];

        switch ((addr & 0b11111)) {
        case 0x00:
          
          break;
        case 0x01:
          
          break;
        case 0x02:
          
          break;
        case 0x03:
          
          break;
        case 0x04:
            target_value.raw[0] = RxData[4];
            target_value.raw[1] = RxData[3];
            target_value.raw[2] = RxData[2];
            target_value.raw[3] = RxData[1];
          dac_set_MPa(target_value.value);
          break;
        default:
          break;
        }
      }
    }
  }
}

void HAL_FDCAN_RxFifo1Callback(FDCAN_HandleTypeDef *hfdcan, uint32_t RxFifo1ITs) {
  if ((RxFifo1ITs & FDCAN_IT_RX_FIFO1_NEW_MESSAGE) != 0){
    FDCAN_RxHeaderTypeDef RxHeader;
    uint8_t RxData[8];

    if (HAL_FDCAN_GetRxMessage(hfdcan, FDCAN_RX_FIFO1, &RxHeader, RxData) == HAL_OK){
      uint32_t rxId = RxHeader.Identifier;
      uint8_t deviceId = rxId & FDCAN_MASK_DEVICE_8;
      if (deviceId >= SOLENOID_COUNT) {
        return;
      }
      if (RxData[0] == PACKET_TYPE_CMD) {
        bool turnOn = (RxData[1] != 0);
        setSolenoidTarget(deviceId, turnOn);
      }
    }
  }
}
/* USER CODE END 1 */
