nityc-d-robo/solenoid_driver/sd_firmware/Core/Src/spi.c

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
/* Includes ------------------------------------------------------------------*/
#include "spi.h"

SPI_HandleTypeDef hspi1;

/* SPI1 init function */
void MX_SPI1_Init(void)
{

  hspi1.Instance = SPI1;
  hspi1.Init.Mode = SPI_MODE_MASTER;
  hspi1.Init.Direction = SPI_DIRECTION_2LINES;
  hspi1.Init.DataSize = SPI_DATASIZE_8BIT;
  hspi1.Init.CLKPolarity = SPI_POLARITY_LOW;
  hspi1.Init.CLKPhase = SPI_PHASE_2EDGE;
  hspi1.Init.NSS = SPI_NSS_SOFT;
  hspi1.Init.BaudRatePrescaler = SPI_BAUDRATEPRESCALER_32;
  hspi1.Init.FirstBit = SPI_FIRSTBIT_MSB;
  hspi1.Init.TIMode = SPI_TIMODE_DISABLE;
  hspi1.Init.CRCCalculation = SPI_CRCCALCULATION_DISABLE;
  hspi1.Init.CRCPolynomial = 7;
  hspi1.Init.CRCLength = SPI_CRC_LENGTH_DATASIZE;
  hspi1.Init.NSSPMode = SPI_NSS_PULSE_DISABLE;
  if (HAL_SPI_Init(&hspi1) != HAL_OK)
  {
    Error_Handler();
  }
}

void HAL_SPI_MspInit(SPI_HandleTypeDef* spiHandle)
{

  GPIO_InitTypeDef GPIO_InitStruct = {0};
  if(spiHandle->Instance==SPI1)
  {
    /* SPI1 clock enable */
    __HAL_RCC_SPI1_CLK_ENABLE();

    __HAL_RCC_GPIOA_CLK_ENABLE();
    /**SPI1 GPIO Configuration
    PA5     ------> SPI1_SCK
    PA6     ------> SPI1_MISO
    PA7     ------> SPI1_MOSI
    */
    GPIO_InitStruct.Pin = GPIO_PIN_5|GPIO_PIN_6|GPIO_PIN_7;
    GPIO_InitStruct.Mode = GPIO_MODE_AF_PP;
    GPIO_InitStruct.Pull = GPIO_NOPULL;
    GPIO_InitStruct.Speed = GPIO_SPEED_FREQ_LOW;
    GPIO_InitStruct.Alternate = GPIO_AF5_SPI1;
    HAL_GPIO_Init(GPIOA, &GPIO_InitStruct);

  }
}

void HAL_SPI_MspDeInit(SPI_HandleTypeDef* spiHandle)
{

  if(spiHandle->Instance==SPI1)
  {
    /* Peripheral clock disable */
    __HAL_RCC_SPI1_CLK_DISABLE();

    /**SPI1 GPIO Configuration
    PA5     ------> SPI1_SCK
    PA6     ------> SPI1_MISO
    PA7     ------> SPI1_MOSI
    */
    HAL_GPIO_DeInit(GPIOA, GPIO_PIN_5|GPIO_PIN_6|GPIO_PIN_7);

  }
}

/* USER CODE BEGIN 1 */

static void deslect(void) {
  HAL_GPIO_WritePin(ADC_CS_GPIO_Port, ADC_CS_Pin, GPIO_PIN_SET);
  HAL_GPIO_WritePin(DAC_CS_GPIO_Port, DAC_CS_Pin, GPIO_PIN_SET);
}

static void select_adc(void) {
  deslect();
  HAL_GPIO_WritePin(ADC_CS_GPIO_Port, ADC_CS_Pin, GPIO_PIN_RESET);
}

static void select_dac(void) {
  deslect();
  HAL_GPIO_WritePin(DAC_CS_GPIO_Port, DAC_CS_Pin, GPIO_PIN_RESET);
}

void dac_init(float target_mpa) {
  deslect();
  dac_write(0x05, 0x000A);

  const uint8_t addresses[] = {0x02, 0x03, 0x08, 0x04};
  const uint16_t values[] = {0x0000, 0x0001, 0x0000, 0x0000};
  for (unsigned i = 0; i < sizeof(addresses); ++i) {
    dac_write(addresses[i], values[i]);
  }
  dac_set_MPa(target_mpa);
}

void dac_write(uint8_t address, uint16_t value) {
  // uint8_t tx[3] = {cmd, data_high, Data_low};
  uint8_t tx[3] = {address, (uint8_t)(value >> 8), (uint8_t)value};
  select_dac();
  HAL_SPI_Transmit(&hspi1, tx, 3, 2u);
  deslect();
}

void dac_set_mV(int32_t target_mv) {
  // target_mv -> 10000 ~ 0[mV]
  if (target_mv <= 0) { target_mv = 0; }
  if (target_mv >= 10000) {target_mv = 10000u; }
  uint32_t code = ((uint32_t)target_mv * 4096u + 10000u / 2u) / 10000u;
  if (code >= 4095u) { code = 4095u; }
  dac_write(0x08, (uint16_t)(code << 4));
}

void dac_set_MPa(float target_mpa) {
  // 0.75[MPa]より大きければ正常でないと判断
  target_mpa = target_mpa / 2.0f;
  if (target_mpa < 0.0f || target_mpa > 0.75f) {
    return;
  }

  float target_mv = target_mpa * (10000.0f / 0.75f);
  dac_set_mV((int32_t)(target_mv + 0.5f));
}
/* USER CODE END 1 */
