nityc-d-robo/solenoid_driver/(commit log)

2026-08-30 add .
    [FDCAN_Transceiver.kicad_sch, ISO_FET.kicad_sch, ISO_Solenoid.kicad_sch, MCU_stm32_g431k8t6.kicad_sch, Solenoid_Isolation.kicad_sch, sd_hardware.kicad_sch]
2026-09-01 create pin label
    [MCU_stm32_g431k8t6.kicad_sch, sd_hardware.kicad_sch]
2026-09-02 add sw
    [sd_hardware.kicad_sch]
2026-09-08 fix var3.0 sd_hardware
    [FDCAN_Transceiver.kicad_sch, MCU_stm32_g431k8t6.kicad_sch, Solenoid_Isolation.kicad_sch, sd_hardware.kicad_pcb, sd_hardware.kicad_sch]
2026-10-01 move stm dir and fix bug
    [fdcan.c, fdcan.h, gpio.c, main.c, main.h, sd_firmware.ioc]
2026-10-06 Change to Photo Relay
    [Solenoid_Isolation.kicad_sch, sd_hardware.kicad_sch]
2026-10-15 created schematic
2026-11-05 masterと統合
