nityc-d-robo/solenoid_driver/(notices)

Notices in the files:
sd_firmware/Core/Src/fdcan.c:
Copyright (c) 2026 STMicroelectronics.
All rights reserved.
This software is licensed under terms that can be found in the LICENSE file
